1brahimsaid/imudatalogger/README.md

# IMU Sports Monitor Repo 🏅

<p align="center">
  
</p>

## What is a [Wearable IMU Sports Monitor 🏅](https://github.com/1brahimsaid/imudatalogger)?

Wearable sports monitor that collects, stores, and analyzes movement data to suggest ways to improve sports performance and prevent injury. The general purpose of this project was to provide low-cost, modular, and simple sports analysis to all who require it, that will fit their needs.

<p align="center">
  <a href="https://github.com/1brahimsaid/imudatalogger">
</p>

## Table of Contents

1. **Proposal**  
2. **Reports**  
3. **Code** 
4. **Project Management** 
5. **Presentation Files** 
6. **Data and Tests**
7. **Research and Links** 
8. **Technical Requirements** 
9. **Images and Video**

### Youtube Demonstration

Demonstration (http://www.youtube.com/watch?v=I2n_vJK3DQo)

> _Click to Proceed to the Video_

This repository contains all the information required to replicate and continue this project. Explanation for the folders that require it follow. 

<p align="center">
  
</p>

*‘**Final Code**’ contains the final Arduino and Python files required to run the project.*  

***Arduino***  

- *LED ~ pin 12*  
- *Button ~ pin 27*  
- *SD Card ~ pin 33*  

***Python***  

- *Install these packages.*  
- *Vpython*  
- *NumPy*  
- *Serial* 

‘**Testing Code**’ contains any  code borrowed, created, or  used to test components and  features.

‘**Recorded Data**’ contains data that was recorded during a trial run or stress test.

‘**Helpful Links and Research**’ contains research, tutorials, debugging tests and anything in between that aided with the project.

‘**Milestone Accomplishments**’ contains video and files that demonstrate project milestones and development stages. This folder also includes a Gantt Chart documenting the dates and times of these milestones. 

‘**Requirements**’ contains the in-depth decision making and process behind the selection of parts. Contains the minimum requirements, technical details, and purchase recommendations drafted to meet the goals set out in the proposal. 

<p align="center">
  
</p>

<p align="center">
  
</p>

...return to [`projects.ibrahimsaid.ca`](https://projects.ibrahimsaid.ca/) or [`ibrahimsaid.ca`](https://www.ibrahimsaid.ca/).
