1brahimsaid/imudatalogger/Requirements/Minimum Requirements.xlsx

Component | Requirements | Minimum Requirement | Notes
Microprocessor
 | CHANNELS
 | SPI | 1 (SD Card)
 | I2C | 1 (IMU) + 3 (additional sensors) = 4 total
 | UART | 1 (Bluetooth)
 | SAMPLING
 | Rate | 300 Hz | Sampling Rates and Sensor Requirements for Kinematic Assessment During Running Using Foot Mounted IMUs (https://ocul-crl.primo.exlibrisgroup.com/discovery/fulldisplay?context=PC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)
 | WEIGHT | < 8 grams
 | SUPPLY VOLTAGE | 2.4 V
 | POWER USAGE | < 20 mA
Sensors
IMU
 | RANGES
 | Accelerometer | ±3g
 | Gyroscope | 450°/s
 | OPERATING TEMPERATURE | -20°C - 40° | Lower Limit was chosen based on worst case outdoor temperature scenario that a typical athlete would compete in, Upper Limit is the same case
 | WEIGHT | < 8 grams
 | DIMENSIONS | 60mm x 90mm x 15mm
 | DEGREES OF FREEDOM | 6
 | RESOLUTION
 | Bits | 8 bits
 | Sensitivity | ±3%
 | SUPPLY VOLTAGE | 2.4 V
 | POWER USAGE | < 20 mA
SD Card
 | Size | 4GB | Limit of fat32 Minimum Size
 | Type | microSD, SDHC
Power Source
Battery
 | Voltage | 2.4 V
 | Capacity | 200mA/(20+20)mA = 5 hours of run time
