1brahimsaid/imudatalogger/Requirements/Technical Information.xlsx

Component | Needs | Requirements (specific) | Other Notes
Microprocessor | SD CARD COMPATIBILITY | SPI Channel via 4 Port Pins | SD Card Standard, Optional: Battery-Backup Feature
 | WIRELESS COMMUNICATION | Bluetooth via Hardware
 | POWER SUPPLY | 3.3V/5V | up to five hours of usage, can power multiple devices through I2C
 | SIZE | under 62mmx88mmx16mm | approximately the size of a deck of cards, most dataloggers previewed are smaller, reasonable size for a wearable device
 | INTERFACE | SPI Channel to SD Card
 |  | I2C to Sensors | modular/room for other sensors with I2C
 | ADC | 8bit to 16bit | increases resolution/quantization quality but pricier
 | ENVIRONMENTAL CONDITIONS | able to withstand wet/humid conditions | SD-Card could be affected by moisture (pin contacts)
 | BATTERY | 2500mAh/200 mA (expandable) = 12.5 hours
 | PERSISTANCE | overrites old data | what occurs when the datalogger runs out of data
 | BONUS FEATURES | time-stamped data
 | WEIGHT | Under 8 grams | Based on similar products/reasonable size to be a wearable device
Sensors
IMU | RANGE | • range of accelleration expected 3g to -3g (accelerometer) • range expected of approx. 450 deg/s gyroscope - IMUs go above and beyond these ranges at a mid-tier price point | • expected ranges based on Gat et al. paper on sled hockey and elite sports IMU information in research documents
 | INTERFACE | • Accelerometer: digital interface, digital output • Gyroscope: digital interface, digital output Both I2C
 | NUMBER OF AXES MEASURED | • Accelerometer: X-Y-Z, comparable price to X-Y • Gyroscope: X-Y only, athletes in question are seated
 | POWER USAGE | under 200 microAmps | reasonable power usage for a wearable device, any larger would require a size that would not be feasible for wearing
 | ENVIRONMENTAL CONDITIONS | able to withstand wet/humid conditions
 | WEIGHT | Under 8 grams | Based on similar products/reasonable size to be a wearable device
 | BONUS FEATURES | • Accelerometer o Sleep control o 0g detection o Selectable measurement ranges
GPS
Heart Rate
Temperature
SD Card
 | CARD TYPE | microSD, SDHC
 | FORMAT | fat32
 | SIZE | max size 32GB, recomended size 16GB
Preference |  | PROS | CONS
IMU | 1. Adafruit BNO055 | • built in fusion algorithms • common, tons of support (libraries for integration and management) • plug and play (no soldering required) • includes temperature sensor | • stock varies but can be found from other sources (amazon & buyapi.ca) | https://www.adafruit.com/product/2472 | https://www.amazon.ca/Adafruit-Absolute-Orientation-Fusion-Breakout/dp/B017PEIGIG https://www.buyapi.ca/product/adafruit-9-dof-absolute-orientation-imu-fusion-breakout-bno055/
 | 2. Adafruit FeatherWing LSM6DSOX + LIS3MDL | • modular, fits in with a Feather Adalogger • cheap • ranges well above what is required for this project | • IMU intergration algorithms must be made/chosen correctly • soldering | https://www.adafruit.com/product/4565
 | 3. MPU9250 - Ultimate Sensor | • offloads sensor fusion, faster • additional pressure and temperature sensor • low power • warm start calibration (saves calibration and can be reused in similar environments) • no soldering • programmable controller | • stock arduino doesn’t work for high frequency • some components cannot handle bright direct sunlight | https://www.tindie.com/products/onehorse/ultimate-sensor-fusion-solution-mpu9250/
Microprocessor | 1. Adafruit Feather nRF52840 Express/Adafruit Feather Adalogger/FeatherWing Doubler/Lithium Ion Polymer Battery - 3.7v 2500mAh | • can be used with phone for real time calibration • includes iOS/Andriod device • arduino or python • RTC for timestamp • RTC backup feature | • soldering • requires additional coin cell to use RTC | https://www.adafruit.com/product/4062 https://www.adafruit.com/product/2922 https://www.adafruit.com/product/2890 https://www.adafruit.com/product/328 (https://www.adafruit.com/product/4062%20https:/www.adafruit.com/product/2922%20https:/www.adafruit.com/product/2890%20https:/www.adafruit.com/product/328) | https://learn.adafruit.com/pulse-oximeter-wireless-data-logger?view=all
 | 2. Same Setup Above with Adafruit Feather M0 Wifi
SD Card | Sandisk Ultra 16GB | • 98 MB/s • SDHC | • not max size but not required, max size would be better if adding additional sensors | https://www.amazon.ca/Sandisk-Ultra-Micro-UHS-I-Adapter/dp/B073K14CVB
